megamind4089/STeMCell/(threads)

Thread 2 (2022-03-17):

Grid ground pours cannot be manufactured at JLCPCB

piit79, 2022-03-17:
Hey, thanks for such a great open-source project! I just ordered a batch of STeMCells at JLCPCB and wanted to mention that they came back saying the resolution of the "grid" in the ground pours is higher than they can manufacture and had to change it to standard solid pours.

I had to find a replacement USB-C socket as the one in the BOM had a stock shortage, and is now also marked as "not recommended for new designs". The one I used has part number C963372.
EDIT: The above USB-C connector was **not the best choice** - it is not fully mid-mounted but rather slightly raised above the bottom of the PCB.

Also, the "corrected" cpl / pos CSV file worked, but all the positions seemed to be off by more or less the same offset and had to be corrected manually. I will try to get the corrected file and submit a PR.

megamind4089, 2022-08-05:
Hi @piit79

Thanks for nice words. Apologies for late reply. I missed this issue.
I have printed/assembled all versions of STeMCell with JLC only, and they printed it properly. I guess its again depend on the panel reviewers.
Some of them are allowing to print it with "grid" ground pour.
I will try to remove it in next major version.

As far as the parts, USB connectors are not fully available all the time. So bear with the burden of searching and changing it while ordering.

Feel free to submit PR for corrected POS file. Will merge it

megamind4089, 2022-08-08:
Both the issues have been fixed now with v2.0.0.
The following render is directly from JLCPCB, and all parts are positioned correctly.

Will close this issue, if you do not have further comments

<p align="center">
  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
&nbsp; &nbsp; &nbsp; &nbsp;
  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
</p>

piit79, 2022-08-08:
That's awesome, thank you!

wantei, 2022-08-08:
Amazing work being done here!

Closed 2022-08-10.
