megamind4089/STeMCell/(commit log)

2022-01-16 Update to v0.0.2
    [stemcell.kicad_pcb, stemcell.kicad_sch]
2022-01-16 Update to v0.1.0
    Add tiny-uf2 bootloader
    [stemcell.kicad_pcb, stemcell.kicad_sch]
2022-01-17 Minor silkscreen update
    [stemcell.kicad_pcb]
2022-01-18 Fix the fill pattern shape for better pcb render
    [stemcell.kicad_pcb]
2022-01-21 Update the schematic fully and assign footprints
    [stemcell.kicad_sch]
2022-01-22 Fully routed with no errors
    [stemcell.kicad_pcb, stemcell.kicad_sch]
2022-01-22 Almost finalised
    [stemcell.kicad_pcb]
2022-01-22 minor tweaks
    [stemcell.kicad_pcb, stemcell.kicad_sch]
2022-01-22 Change 0.1uF to 100n
    [stemcell.kicad_pcb, stemcell.kicad_sch]
2022-01-22 Change LED to 0603
    [stemcell.kicad_pcb, stemcell.kicad_sch]
2022-01-22 Update to v1.0.0.rc1
    [stemcell.kicad_pcb]
2022-02-12 Update version number and readme
    [stemcell.kicad_pcb, stemcell.kicad_sch]
2022-08-08 Update to v2.0.0 (#3)
    * Update to v1.0.1
    * Visual improvements (#1)
    * Update silkscreen
    * consistent fonts
    * Add castellated pads
    * Remove gerber folder
    * Update readme with 1.0.2 image
    * Update LCSC Part numbers
    * Use SOT123 for diode. Add lcsc part number. Use vbus_ff for vdd
    * Add v2.0.0
    [stemcell.kicad_pcb, stemcell.kicad_sch]
2022-09-06 Castellated holes fix + 6x panel (#6)
    [stemcell-panel.kicad_pcb, stemcell.kicad_pcb]
